omm-narayan/Chippy/assets/small.png

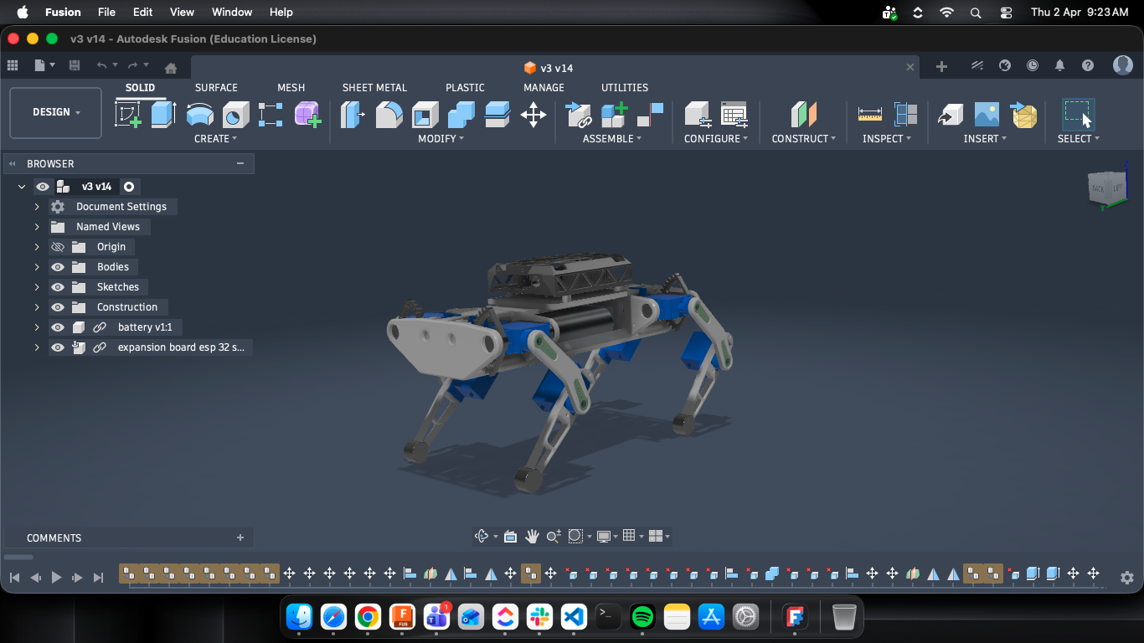
assets/small.png
